G-uruCPQ/Portable_Amp_Speaker/circuit/構想.md

# 構想
## コンセプト
シンセサイザーRK 100S-2に使える、電池駆動のポータブルアンプスピーカーが作りたい。<br>
歩き回れて楽しいねがしたい。
## 簡易構成図
```mermaid
flowchart LR
    %% ===== Audio path =====
    subgraph AUDIO["音声信号系"]
        A["RK-100S<br/>6.3 mm TRS ステレオ出力"]
        B["L/R加算抵抗<br/>L: 10 kΩ, R: 10 kΩ"]
        C["音量ボリューム<br/>Aカーブ 50 kΩ"]
        D["入力カップリング<br/>＋簡易HPF"]
        E["PAM8302A<br/>モノラル Class-D アンプ"]
        F["4 Ω フルレンジ<br/>スピーカー"]
        A --> B --> C --> D --> E --> F
    end

    %% ===== Power path =====
    subgraph POWER["電源系"]
        P1["単3 NiMH ×3本<br/>約 3.0 ～ 4.3 V"]
        P2["電源スイッチ"]
        P3["電源デカップリング<br/>100～470 µF + 1 µF + 0.1 µF"]
        P1 --> P2 --> P3 --> E
    end

    %% ===== Ground relation =====
    G["GND共通"]
    A --- G
    B --- G
    C --- G
    D --- G
    E --- G
    P1 --- G
```
## 部品選定
|部品|品番、仕様|数量|備考|url|
|----|----|----|----|---|
|フォンプラグジャック|6.35 mm TRSメス|1|第2アメ横ボントンにて購入||
|抵抗||2|10 kΩ、L/R加算||
|可変抵抗|Aカーブ 50 kΩ|1|マスターボリューム<br>第2アメ横ボントンにて購入||
|パワーアンプ|PAM8302AADCR|1|モノラルClass-D|https://akizukidenshi.com/catalog/g/g114187/|
|抵抗||2|47 kΩ、||
|コンデンサ||2|22 nF、HPF||
|セラミックコンデンサ||1|0.1 μF、X5R<br>電源デカップリング||
|セラミックコンデンサ||1|1 μF、X5R<br>電源デカップリング||
|セラミックコンデンサ||1|10 μF、X5R<br>電源デカップリング||
|電解コンデンサ||1|470 μF<br>電源デカップリング||
|スピーカー|4 Ω、φ65.5 mm|1|第2アメ横ボントンにて購入||
|単3 NiMH||3|手持ちのeneloop利用||
|電池ホルダ|単3x3、スイッチ付き|1|第2アメ横ボントンにて購入||
|ツマミ||1|第2アメ横ボントンにて購入||
