G-uruCPQ/Portable_Amp_Speaker/circuit/Portable_Amp_Speaker/Portable_Amp_Speaker.step

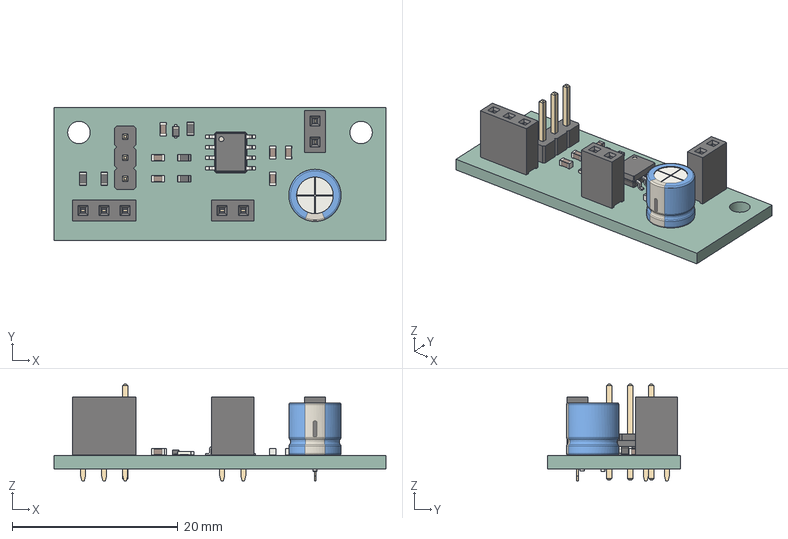
[picture p1: CAD file, 2026-08-13]
circuit/Portable_Amp_Speaker/Portable_Amp_Speaker.step
40.0 x 16.0 x 11.6 mm
R_0603_1608Metric x 5
PinSocket_1x03_P254mm_Vertical
C_0603_1608Metric x 6
CP_Radial_D63mm_P250mm
PinSocket_1x02_P254mm_Vertical x 2
PinHeader_1x03_P254mm_Vertical
SOIC_8_39x49mm_P127mm
D_SOD_523
Portable_Amp_Speaker PCB
