G-uruCPQ/Portable_Amp_Speaker/circuit/Portable_Amp_Speaker/Portable_Amp_Speaker.kicad_pcb

## KiCad design circuit/Portable_Amp_Speaker/Portable_Amp_Speaker.kicad_pcb (2026-08-13)

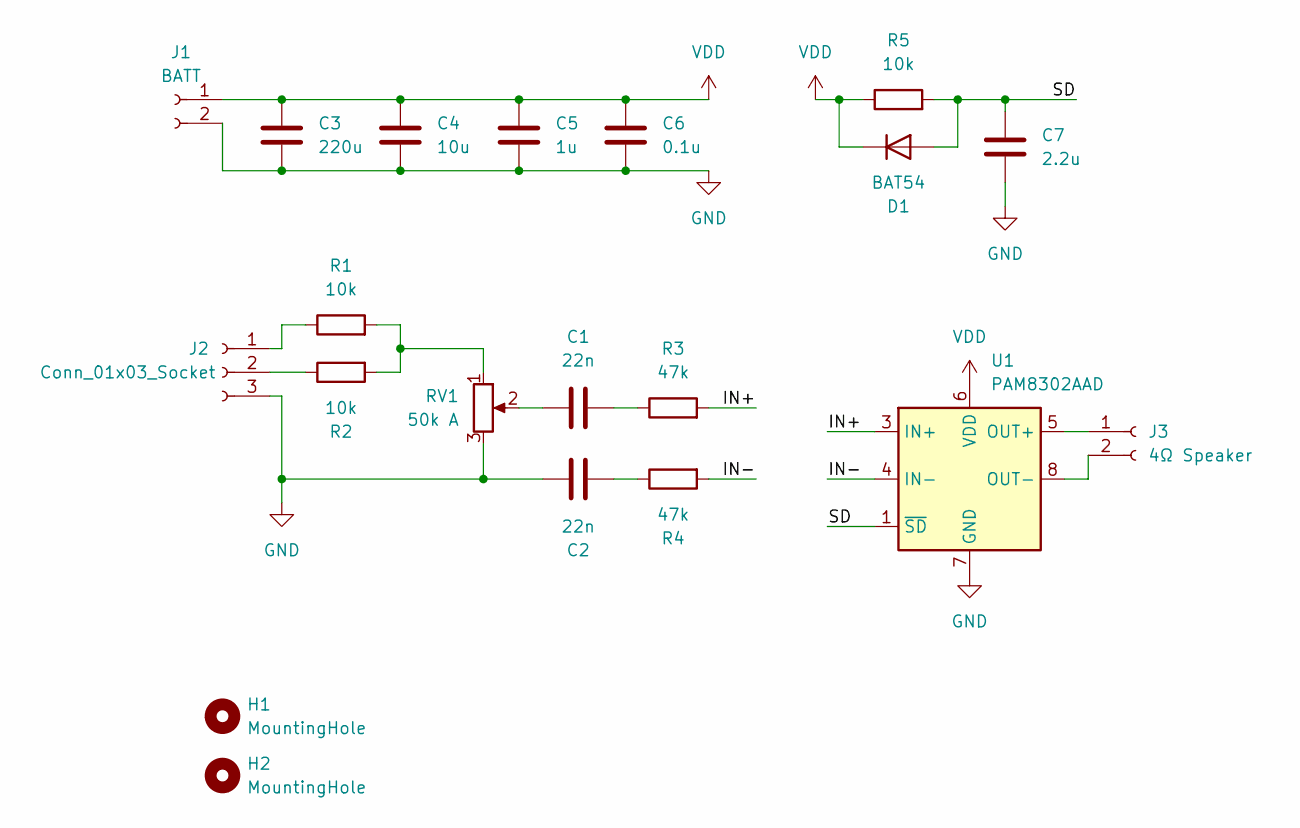
[picture p2: schematic Portable_Amp_Speaker.kicad_sch]

Parts:
C1, C2: 22n; C_0603_1608Metric
C3: 220u; CP_Radial_D6.3mm_P2.50mm
C4: 10u; C_0603_1608Metric
C5: 1u; C_0603_1608Metric
C6: 0.1u; C_0603_1608Metric
C7: 2.2u; C_0603_1608Metric
D1: BAT54; D_SOD-523
H1, H2: MountingHole; MountingHole_2.7mm_M2.5
J1: BATT; PinSocket_1x02_P2.54mm_Vertical
J2: Conn_01x03_Socket; PinSocket_1x03_P2.54mm_Vertical
J3: 4Ω Speaker; PinSocket_1x02_P2.54mm_Vertical
R1, R2, R5: 10k; R_0603_1608Metric
R3, R4: 47k; R_0603_1608Metric
RV1: 50k A; PinHeader_1x03_P2.54mm_Vertical
U1: PAM8302AAD; SOIC-8_3.9x4.9mm_P1.27mm

Connections:
/IN+: R3.2, U1.3 (IN+)
/IN-: R4.2, U1.4 (IN-)
/SD: C7.1, D1.2 (A), R5.2, U1.1 (~SD)
GND: C2.1, C3.2, C4.2, C5.2, C6.2, C7.2, J1.2, J2.3, RV1.3, U1.7 (GND)
unnamed: C1.1, RV1.2
unnamed: C1.2, R3.1
unnamed: C2.2, R4.1
unnamed: J2.1, R1.1
unnamed: J2.2, R2.1
unnamed: J3.1, U1.5 (OUT+)
unnamed: J3.2, U1.8 (OUT-)
unnamed: R1.2, R2.2, RV1.1
VDD: C3.1, C4.1, C5.1, C6.1, D1.1 (K), J1.1, R5.1, U1.6 (VDD)

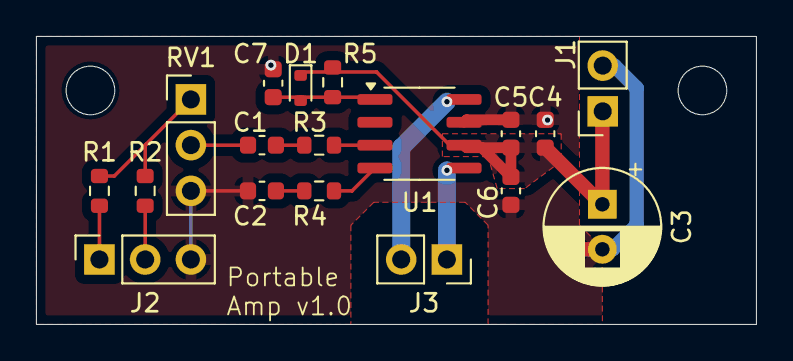
[picture p3: board Portable_Amp_Speaker.kicad_pcb from above]

Board: 2 copper layers, 40.0 x 16.0 mm, 20 parts (0 on the bottom side), 13 nets.
