G-uruCPQ/Portable_Amp_Speaker/(commit log)

2026-08-08 回路構想
2026-08-08 KiCADプロジェクト生成
    [Portable_Amp_Speaker.kicad_pcb, Portable_Amp_Speaker.kicad_sch]
2026-08-11 購入品に合わせて部品表更新
2026-08-11 ハードプロジェクト初期化
2026-08-13 KiCadでいらないものをgitignoreに追加
2026-08-13 基板設計
    [Portable_Amp_Speaker.kicad_pcb, Portable_Amp_Speaker.kicad_sch]
2026-08-13 circuit branchで編集したgitignoreのcheckout
2026-08-13 基板3Dモデルの出力
    [Portable_Amp_Speaker.step]
